tmolteno/TART/doc/README.md

# TART Radio Telescope Documentation

* [Getting Started](getting_started/README.md)
* [Calibration](calibration/README.md)

## Miscellaneous Other Documentation

This is contained in the misc subfolder.
