tmolteno/TART/hardware/antenna/README.md

# Antenna Design for TART

## Conventional GPS antenna

The TART telescope can operate with standard off-the-shelf antennas

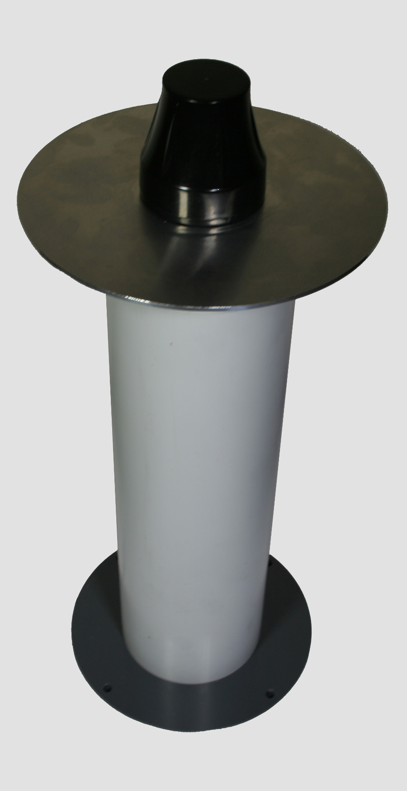
[picture p5: doc/img/antenna.jpg]
All-sky antenna on a pedestal (for snow clearance)
  

## Other Antenna Ideas

Goal. A simple radiation pattern insensitive to polarization with approximately 90 degree beam width.

[antenna_image]: https://github.com/tmolteno/TART/blob/master/doc/img/antenna.jpg "All-sky GPS antenna"
