tmolteno/TART/software/python_modules/tart_web_api/tart_web_api/README.md

# TART Web API service

This is a restful API service that runs on the raspberry pi that controls the telescope.

## Installation

This is installed using docker. See the TART/scripts directory for install instructions.
