tmolteno/TART/software/containers/web_app/web-app/api_imaging/README.md

# TART Synthesis

Provide visibilities and antenna positions as well as imaging parameters to this module. Returns a canvas of the synthesis image (`dirty image`).

## Install

```
sudo apt-get install nodejs-legacy
sudo npm install npm -g
npm install
```

## Build Example

    make exa

## Run example

    firefox ./example/index.html

NOTE: This does not work if webpack uses production mode!
