tmolteno/TART/software/python_modules/tart/tart/test/full_sim_spectrum.png

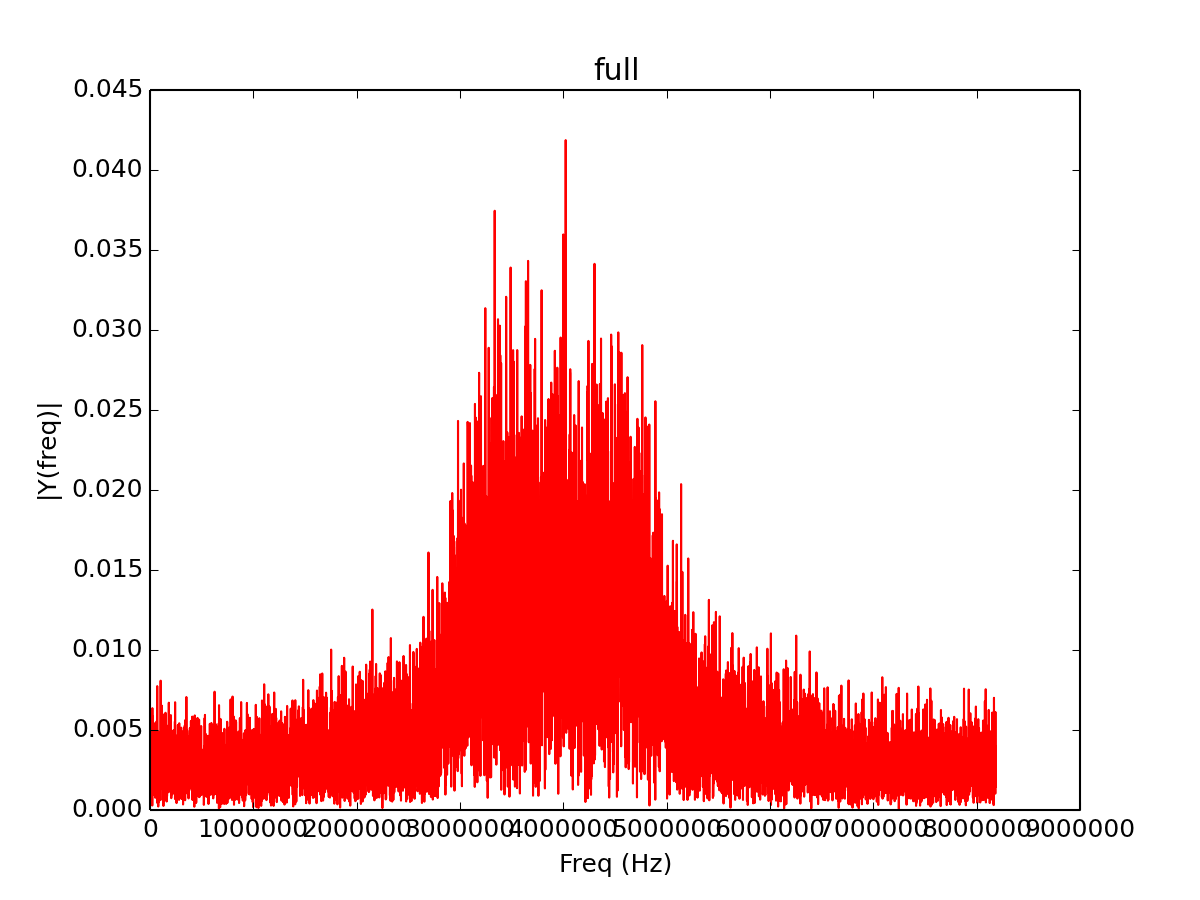
software/python_modules/tart/tart/test/full_sim_spectrum.png
