tmolteno/TART/hardware/antenna/base.fcstd

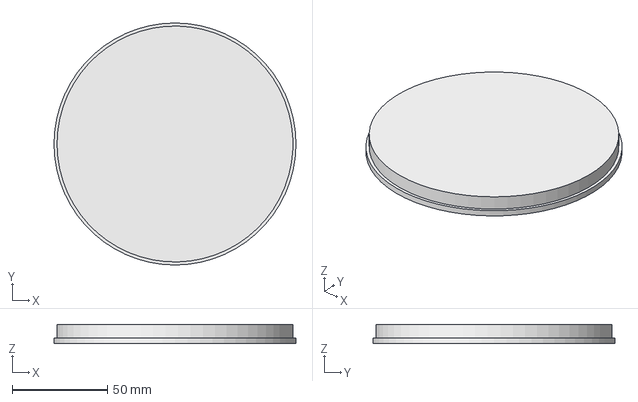
[picture p9: CAD file, 2016-05-03]
hardware/antenna/base.fcstd
127.0 x 127.0 x 10.0 mm
