tmolteno/TART/hardware/antenna/cylinder.fcstd

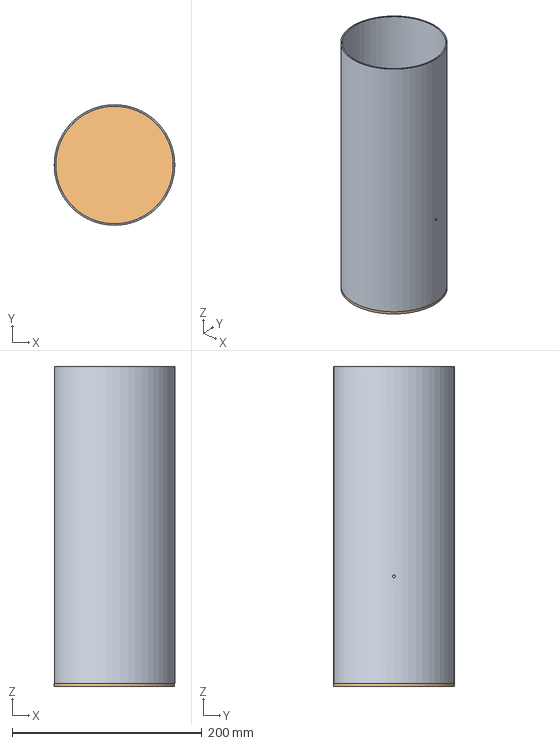
[picture p10: CAD file, 2016-05-03]
hardware/antenna/cylinder.fcstd
127.0 x 126.9 x 337.0 mm
