tmolteno/TART/hardware/FPGA/INSTALL.md

# TART FPGA INSTALL

Compiling the Verilog code that describes the FPGA functionality requires the Xilinx toolchain. 

## INSTALL CURRENT FIRMWARE

To simply install the current, the FPGA must be programmed.

## Firmware development
