tmolteno/TART/software/python_modules/tart/tart/test/test_data/signal_means.png

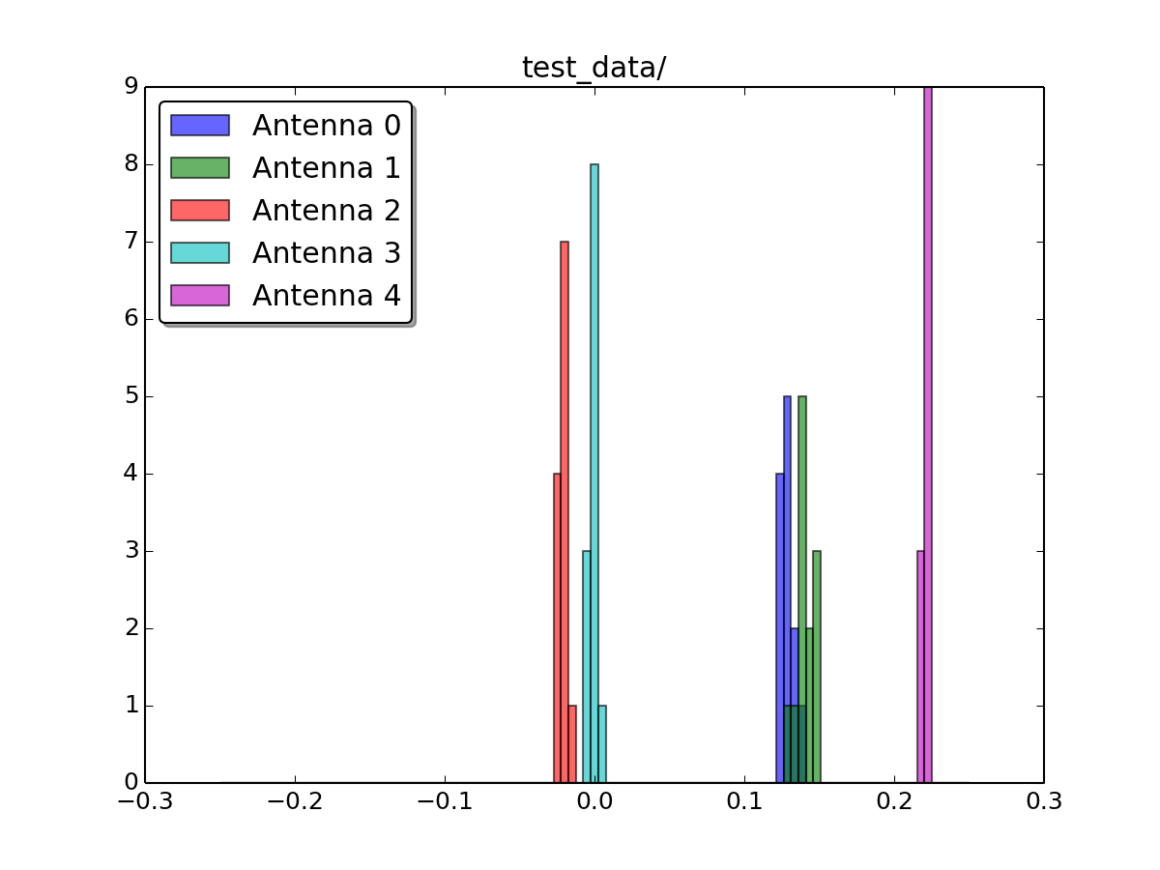
software/python_modules/tart/tart/test/test_data/signal_means.png
