tmolteno/TART/(threads)

Thread 1 (2014-08-21):

Merge Radio Board and Jitter Cleaner Module

tmolteno, 2014-08-21:
Rename ClockModule + Radio Board -> Radio Hub

Add mounting holes
Cleanup Silk Screen
1.6 mm board.

tmolteno, 2015-02-03:
Completed an uploaded to GIT.

Closed 2015-02-03.

Thread 2 (2014-11-23):

SPI speed limitation to 7.8 MHz

maxscheel, 2014-11-23:
Papillio Pro <-> RPi SPI speed limited to 7.8 MHz.
Faster speeds will cause issues as the Papillio latches to the sclk provided by the RPI. 96 MHz is too slow to latch to rising and falling edge. SPI client needs a make over.

tmolteno, 2016-05-14:
Now being worked on.  SPI rewrite in progress by @patsuggate

psuggate, 2016-05-14:
Hey Tim,

How'd ya do that?

On Sat, May 14, 2016 at 7:41 PM, Tim Molteno <notifications@github.com>
wrote:

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

Closed 2016-06-27.

Thread 5 (2017-07-05):

Web-App Enhancements

tmolteno, 2017-07-05:
Checklist of minor enhancements for the Web-GUI [https://tart.elec.ac.nz](url)

- [x] Add version number to bottom
- [x] Fix API documentation link
- [x] Add meta-information to the image view pane (date, number of baselines, integration time e.t.c)
- [x] Add telescope information to the landing page (location, number of antennas e.t.c)
- [x] Add a loading screen
- [x] Change title to "Radio Telescope Console" from TartApp

milletf1, 2017-07-05:
I have managed to get the API link to serve up api documentation.  However, it is setting the browser address to localhost/doc/.  I think this is caused by the nginx config because the response headers are returning Location: "http://localhost/doc/".

tmolteno, 2017-07-12:
Closing, as these have been largely done. Any refinement and we'll create a new issue.

Closed 2017-07-12.

Thread 6 (2017-07-06):

Spectrum View

tmolteno, 2017-07-06:
Needs to acquire raw data, will be very slow via the API.

tmolteno, 2017-07-06:
Can downscale so the FFT is faster.

maxscheel, 2017-07-26:
API now returns two additional keys 'freq' and 'power'
http://tart2-raspberry/api/v1/status/channel/0
http://tart2-raspberry/api/v1/status/channel
display power(y) vs freq(x) with perhaps:
http://www.chartjs.org/samples/latest/charts/scatter/basic.html

Closed 2017-08-02.

Thread 9 (2017-07-09):

Image time is incorrect

tmolteno, 2017-07-09:
The image time appears to be 12 hours early. At 09:14 on Monday July 10 NZST it displays.

Recorded: Sun Jul 09 2017 21:14:59 GMT+1200 (NZST).

Correct behaviour is for the API to return UTC, and the browser to display in local time.

tmolteno, 2017-07-09:
The API http://tart2-raspberry/api/v1/imaging/timestamp uses isoformat() but does not include a time zone. Here is an example: 2017-07-09T21:25:03.794269. I suspect the error is in the JavaScript that should interpret this as an UTC time.

milletf1, 2017-07-09:
I can get it to display the time like 10/07/2017, 09:27:03.  Is that what you had in mind?

tmolteno, 2017-07-09:
I think that in web-app/src/app/services/imaging.service.ts, the getTimeStamp method should convert to local time, or set the time zone on a Date object to UTC. Then the javascript can display knowing the correct time zone.

tmolteno, 2017-07-09:
Alternatively the API should include a time zone of UTC in the string?

milletf1, 2017-07-09:
date.toLocaleString() outputs the time as I have displayed above.

tmolteno, 2017-07-09:
Perhaps the issue is browser dependent. I'm on a Chromebook, and the image from Monday morning shows a time 12 hours early (it does include NZDT, it just happens to be 12 hours out)

Closed 2017-07-12.

Thread 10 (2017-07-12):

Default imaging interval should be 15

tmolteno, 2017-07-12:
One some slow browsers (i.e. firefox on android) with slow connections the 5 second refresh interval seems too fast  - it takes longer than 5s to render. Suggest 15?

milletf1, 2017-07-12:
Sounds good, I will add this to my next commit.

Closed 2017-07-12.

Thread 18 (2017-07-19):

Error in status map

tmolteno, 2017-07-19:
On firefox, I get "TypeError: i.ellipse is not a function". When using the status map.

Stacktrace.
.sTWA/s</e.prototype.drawAntennaPositions/<()
forEach()
.sTWA/s</e.prototype.drawAntennaPositions()
.sTWA/s</e.prototype.ngOnChanges()
.SMJ5/x</e.prototype.ngDoCheck()
.B3Ku/V</t.prototype.detectChangesInternal()

tmolteno, 2017-07-19:
Confirmed as fixed.

Closed 2017-07-19.

Thread 19 (2017-07-20):

colourscale array gets truncated by webpack

maxscheel, 2017-07-20:
some colourmaps are not available

maxscheel, 2017-07-20:
not important issue. something todo with webpack exports

milletf1, 2017-07-24:
I think the problem is that the colours that you want aren't available in version 1.x.x, which is the version of colormap that is required by apply-colormap.

Closed 2017-07-26.

Thread 22 (2017-07-24):

colour selection for vis imaging only works on localhost

milletf1, 2017-07-24:
Not sure why this is, will try fix tomorrow.

milletf1, 2017-07-24:
This issue is being caused when the save-pixels package is given an array of  coloured pixels in production builds.  I'll debug this at a later date.

maxscheel, 2017-07-26:
lets just use our own colouring. i updated the api_synthesis package to only depend on colormap (with viridis support) and removed dep to apply_colormap (not maintained.)

providing "viridis" now working.

Closed 2017-07-26.

Thread 23 (2017-07-26):

API - Number of samples exponent in vis mode

maxscheel, 2017-07-26:
Number of samples exponent when changed, need to reconfigure the FPGA. Changing values breaks telescope process (API will still run, but telescope won't react)

psuggate, 2017-07-26:
The hardware won't automatically issue a reset & flush the buffers, if the exponent is changed mid-calculation, so you'll have to do that from the RPi, and change the web-app's state accordingly?

maxscheel, 2017-07-26:
Yip. Don't worry, I'll handle it. No action required from your side :)

Thread 28 (2017-08-24):

WebM Encoder using ffmpeg.js

tmolteno, 2017-08-24:
The npm package ffmpeg.js a pretty powerful video encoder that runs in the browser. It can encode a sequence of images to a webM movie. The specific package is probable (ffmpeg-worker-webm.js).

See: https://stackoverflow.com/questions/40560255/ffmpeg-jpeg-stream-to-webm-only-creates-a-file-webm-with-1-frame-snapshot-or

Also: https://github.com/spite/ccapture.js/

Thread 29 (2017-08-29):

Upgraded clock distribution on radio hub boards

tmolteno, 2017-08-29:
Use a zero-delay clock buffer in place of the jitter cleaner, driving a RC low pass filter.

* Tune filter to achieve the right output level, and reasonable cut-off.
* Shift board to Kikad
* Reuse existing radio modules.
* Use new driver chips.

Thread 33 (2018-03-16):

Extracting individual antenna signals

danieludick, 2018-03-16:
Good day,

I would like to extract the individual (time sampled) signals from each of the antennas for our setup in SA. I am logging in to my Raspberry pi and I execute:

``
/git/TART/software/python/tart/tart/simulation $ python telescope_system.py
``

I am however getting the following error:

``
Traceback (most recent call last):
  File "telescope_system.py", line 13, in <module>
    rad = radio.Max2769B(sample_duration = 1e-5)
TypeError: __init__() got an unexpected keyword argument 'sample_duration'
``

The installation is also already up to date (I think). After pulling from the repo, I issued:

``
/home/pi/git/TART/software/python/tart_web_api and issue: sudo python setup.py install
``

Perhaps there is another setup.py to run?

danieludick, 2018-03-16:
There is another script that I located (test_radio.py), that looks useful here. When I run it however, then it also exhibits an issue:

``
pi@tart2-orange:~/git/TART/software/python/tart/tart/simulation/test $ python test_radio.py
Traceback (most recent call last):
  File "test_radio.py", line 10, in <module>
    from tart.simulation import spectrum
ImportError: cannot import name spectrum
``

maxscheel, 2018-03-16:
Hi Danie,
You went down the wrong rabbit hole and discovered lots of software/bit rot :1st_place_medal:

Ideally you want to download the raw data file to your desktop. On your desktop should already have the tart python package installed (pip install tart)

I just added a simple script for time sampled signals from raw data pkl files in:
TART/doc/getting_started/time_sampled_signals.py

The latter is a stripped version of the spectrum generation from raw data which can be found here:
TART/doc/getting_further/spectrum/raw_data_info.py

Thread 35 (2018-04-14):

external paths still exist in web api

maxscheel, 2018-04-14:
currently requires (hardcoded) folder called 24_ant_setup with:
a) telescope_config.json
b) calibrated_antenna_positions.json
this is also the path where the gains.db sqlite data base is stored.

changes need to made in:
tart_web_api/config.py
tart_web_api/database.py

make sure that api can be installed and run by just 2 steps.
1) sudo pip install tart_web_api
2) LOGIN_PW=foobar FLASK_APP=tart_web_api flask run

tmolteno, 2019-02-14:
This has been fixed (to some extent) in the recent containerised web_api. Persistence is still being worked on.

tmolteno, 2019-07-11:
Closed as the API is now containerised

Closed 2019-07-11.

Thread 36 (2019-02-06):

Errors while building the Docker containers (calibration_server, object_position_server)

danieludick, 2019-02-06:
I am currently trying to setup a calibration server for our TART telescope in SA. First off, I want to get the object_position_server going and tested on an Ubuntu machine. I am getting the following error after following the README.md file contained in that directory:

> $ docker-compose build
> Docker machine "default" does not exist. Use "docker-machine ls" to list machines. Use "docker-machine create" to add a new one.
>

For reference, I am unexperienced with Docker and might not have installed everything that is required. I did the following:

> sudo snap install docker
> sudo apt install docker-compose

Is there anything I am missing?

danieludick, 2019-02-06:
I seemed to have moved a bit further now by issuing:

> sudo docker-compose build

But still I get that the build failed due to:

> ERROR: Service 'object-position-server' failed to build: The command '/bin/sh -c apt-get install -y python-numpy python-dateutil' returned a non-zero code: 100

The full output are as follows:

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

```

tmolteno, 2019-02-06:
The issues appear to be related to external web access on the machine. The docker image is unable to access the external repositories (deb.debian.org) to get the list of software. This means it can't find the numpy and dateutil packages.

More specifically, It seems that the DNS system on the computer running docker does not resolve the 'deb.debian.org' domain name. Could you check the output of the following command (assuming you're running some form of Linux)

    wget http://deb.debian.org/debian/dists/stretch/

Your output should look something like...

```
$ wget http://deb.debian.org/debian/dists/stretch/
--2019-02-07 09:08:33--  http://deb.debian.org/debian/dists/stretch/
Resolving deb.debian.org (deb.debian.org)... 149.20.4.15, 128.31.0.62, 130.89.148.14, ...
Connecting to deb.debian.org (deb.debian.org)|149.20.4.15|:80... connected.
HTTP request sent, awaiting response... 302 Found
Location: http://cdn-fastly.deb.debian.org/debian/dists/stretch/ [following]
--2019-02-07 09:08:34--  http://cdn-fastly.deb.debian.org/debian/dists/stretch/
Resolving cdn-fastly.deb.debian.org (cdn-fastly.deb.debian.org)... 151.101.232.204, 2a04:4e42:37::204
Connecting to cdn-fastly.deb.debian.org (cdn-fastly.deb.debian.org)|151.101.232.204|:80... connected.
HTTP request sent, awaiting response... 200 OK
Length: 1801 (1.8K) [text/html]
Saving to: ‘index.html’
```

danieludick, 2019-02-07:
Thanks @tmolteno . I ran now the command you suggested and got the following (seems to be what is expected):

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

I then tried the following again:

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

danieludick, 2019-02-07:
This seems to be a networking/firewall issue with our University. I tried now with another Ubuntu PC connected to the internet and was able to get the following output after issuing:
> docker-compose build

Output:

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

Then following the steps in the [README.md](https://github.com/tmolteno/TART/tree/master/software/containers/object_position_server/README.md) I did the following:

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

Not sure if this error is really an issue? I tested it as follows:

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

So it seems to be working. Not sure the networking issue is worth trying to resolve. I am going to continue with the calibration server install now on this PC outside of the network that gives issues, and then try and connect it to the Univ. network afterwards to calibrate the TART system we have here.

danieludick, 2019-02-07:
Started now with the calibration_server (also on the same host where the object detection server is running). Running in to the following error when running **sh build.sh**:

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

tmolteno, 2019-02-07:
Thanks for the report. It looks like the docker image was based on a testing distribution of debian where those packages had been temporarily disabled. I'm curently testing a fix to base it off a stable version.

tmolteno, 2019-02-07:
@danieludick  Could you please pull the latest version, it seems to fix the issue here at least.

danieludick, 2019-02-08:
Thanks @tmolteno . Pulling the latest version seemd to work :). The calibration is still running. I will close the issue once I can confirm that everything works as expected.

tmolteno, 2019-02-13:
@danieludick  I have made a few documentation changes to try and avoid duplicating instructions for software installation, and also to make the flow a little more logical.

danieludick, 2019-02-21:
Just a note on this issue:

- To get the Docker installation sorted out on Ubuntu 18.02, one should follow steps as outlined on https://www.digitalocean.com/community/tutorials/how-to-install-and-use-docker-on-ubuntu-18-04, as the Docker installation package available in the official Ubuntu repository may not be the latest version.

- Also for the Object position server, I had to change the following in the Dockerfile:

> #FROM debian:stretch-slim
> FROM debian:stretch

Then everything built. The servers are now installed on my machine and I am going to close this issue.

Closed 2019-02-21.

Thread 37 (2019-02-14):

Antenna positions not uploaded correcty to (SA) TART

danieludick, 2019-02-14:
As part of the S.A. TART calibration process, I measured the antenna positions. This was done according to the Jupyter notebook listed in https://github.com/tmolteno/TART/tree/master/doc/calibration/positions.

I  replaced all the measurements wiith our ones. Something that I did however change, was the antenna positions, which is entered into the following array (which accordingly is the distance from each antenna to the reference poles: x0, x1 and x2).

> m[0,:] = [1563, 855, 2618]

I assumed the above example was incorrect, as the order of the columns 1 and 2 is interchanged, i.e. it should be:

> m[0,:] = [855,1563, 2618]

After entering our data, I generated the attached JSON file: (note i merely renamed it to .txt for the upload to Github): [tart_positions_2019-02-14.txt](https://github.com/tmolteno/TART/files/2865369/tart_positions_2019-02-14.txt)

I then submitted the data to the TART, as follows:

> /usr/local/bin/tart_upload_antenna_positions --api http://146.232.222.105 --pw changethispw --file tart_positions_2019-02-14.json

 and received the response:

> Response: {}

I then downloaded the antenna gains again from our TART (in order to verify that they are properly set), but they did not correspond to what I uploaded (see the attached file): [antenna_positions.txt](https://github.com/tmolteno/TART/files/2865378/antenna_positions.txt)

However, after putting our TART in Diagnose mode, the status map of the antennas changed completely:

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

This is not correct.

I am probably doing something wrong here. Should I also add the antenna positions as in the example, i.e. [distance from antenna to x1, ..x0, x2 ] ?

tmolteno, 2019-02-14:
Thanks for the report. Looking into it at the moment, and suspect that the API-uploaded telescope positions aren't sticking properly. Will update when I find more.

The positions can also be updated by modifying the json file in
     software/telescope_web_api/config_data/calibrated_antenna_positions.json
and rebuilding the docker module (docker-compose build in the top level directory)
These positions are then permanently modified (the API uploaded ones don't survive a reboot)

tmolteno, 2019-02-14:
The notebook is very ambiguous, so I have updated it. The m[i,j] are the measurements (in mm) from x1, x0, x2 respectively - yes its very confusing!

tmolteno, 2019-02-15:
I have updated the tart-tools package. Please update with

    sudo pip install tart-tools --upgrade

This will report more useful error messages, as well as reporting 'SUCCESS' if the upload works. Also have updated the documentation to use the tart-tools binaries for uploading.

tmolteno, 2019-07-11:
Closing this as I believe this issue has been worked out.

Closed 2019-07-11.

Thread 38 (2019-02-15):

REPORT better errors when the binary tools fail

tmolteno, 2019-02-15:
The current tools report a not-very-useful "Response: {}" when they correctly upload gains or positions. Change this to SUCCESS.

Closed 2019-02-15.

Thread 39 (2019-02-21):

TART-ZA (TART in South Africa) remains uncalibrated even after running continuous calibration script

danieludick, 2019-02-21:
After installing the latest object detection server and calibration software on my Ubuntu 18.04 PC, I am not having any luck with our TART system in SA.

For reference, the image produced looks as follows:

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

Just for reference, this calibration was run using the following:

> sudo docker run --rm -d -e TART_LOGIN_PW=SAPWD -e TART_API=http://146.232.222.105 -v ~/calibration_results:/app --name=cal -it tart_calibration_server

Then I did:

> docker exec -it cal bash

And when inside the bash attached to this docker machine, I executed the following:

> sh /tart_calibrate.sh

The following output snippet was produced:

```
...
Calibration output is in /app/cal_2019_02_20_15_38_37.json
SUCCESS
Uploading new antenna positions
SUCCESS

```

There is a directory in my $HOME with the following content:

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

I have attached now the file cal_2019_02_20_15_38_37.json (added .txt extension to get it on GitHub):

[cal_2019_02_20_15_38_37.json.txt](https://github.com/tmolteno/TART/files/2887790/cal_2019_02_20_15_38_37.json.txt)

danieludick, 2019-02-21:
Just also to mention: The software on our Raspberry Pi for TART-ZA is still running the original code that was sent to us. After performing antenna position measurements (as documented here), I uploaded the following files to the Pi's directory: **/home/pi/git/TART/hardware/rpi/24_ant_setup**

[calibrated_antenna_positions.json.txt](https://github.com/tmolteno/TART/files/2887811/calibrated_antenna_positions.json.txt)
[telescope_config.json.txt](https://github.com/tmolteno/TART/files/2887812/telescope_config.json.txt)

tmolteno, 2019-02-21:
Thanks for the report. The calibration minimum is returning -7 (this is a log of the function that is minimising) and usually we get around -11.0. A couple of questions.

1) Could you check the timing of the files. There appear to be two files created with close together dates (roughly 2.5 minutes apart) . Is there a chance that you're running two copies of the calibration script? (this shouldn't really stop the calibration working however).

2) Are the diagnose mode outputs showing all green in the telescope web application?

danieludick, 2019-02-21:
The status map of the antennas show all green:

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

I did observe just after uploading this, that one of the status flags changed red for a short duration. but is back on green now.

Also seems there is some strong source nearby:

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

Also clear when looking at the spectra (here the antenna that shows a

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

tmolteno, 2019-02-21:
There looks to be a fair amount of RF interference in those spectra. Here is a single antenna spectrum from a telescope at a quiet site:

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

danieludick, 2019-02-22:
Thanks @tmolteno . Added now the calibration.log file

[calibrate.log](https://github.com/tmolteno/TART/files/2893055/calibrate.log)

tmolteno, 2019-02-23:
Thanks for the log file, the calibration process is not doing a good job of finding good phases and gains. I will try and come up with a good way to check for RF interference.

The visibilities can be retrieved from the telescope via the API. Here is how to get them from our live telescope: (https://tart.elec.ac.nz/signal/api/v1/imaging/vis). This will list the real and imaginary parts of the visibilities.

If there is strong RFI, the visibility amplitudes may be approaching 1.0. Typically they should be around 0.2. What numbers are you getting?

**I've just noticed that there is a very bright satellite (LUCH 5A) dominating the sky here. This may cause calibration issues.**

tmolteno, 2019-02-23:
You can monitor visibilities using the script in /github/TART/doc/calibration/radio_hub. The following command will show the antenna pair 2-3 visibility as a function of time.

    python monitor_vis.py --api https://tart.elec.ac.nz/signal --i 2 --j 3

danieludick, 2019-02-24:
Thanks @tmolteno . I will check the visibilities. Looking at the spectra, I also see that one of the Radio Hubs might be exhibiting on-board RFI (see Antenna 12 cluster).

We are planning to build also a new Radio Hub board. If you get a chance, will you please upload a bill of materials for the components.

danieludick, 2019-03-01:
Plotted now the monitored visibilities using the monitor_vis.py script for antennas 2 and 3:

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

tmolteno, 2019-03-04:
Hi @danieludick. The BOM has been uploaded to

     hardware/pcb/radio_hub_module/RadioHub2.1/RadioHub2.1_.html

Apologies for the delay.

tmolteno, 2019-03-04:
Those visibilities look reasonable, in that the phase is slowly changing (Consistent with things moving over the sky). Could you run the command for a short baseline pair, and a long baseline pair (roughly east-west) and you should see the phase changing faster in the long pair, vs the short pair.

Thread 41 (2019-06-14):

TARTZA installation fails with docker-compose up

danieludick, 2019-06-14:
We are currently in a process of updating our TART in SA (i.e. TARTZA) to Python3. After installing Raspbian v9 (stretch) on a Pi 3B+, we still cannot get the new telescope software to run.

We completed all steps detailed in the [README](https://github.com/tmolteno/TART/blob/master/software/README.md) but when we execute `docker-compose up` we get a range of errors, including the following:

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

Do you have any recommendations for us?

danieludick, 2019-06-14:
Please note, we have not made any changes to the FPGA software (that is still running the original code that we received with our TART).

tmolteno, 2019-06-17:
I will look into this, and try and duplicate it here. Can you issue the following command on the pi (in the software directory)

    docker-compose logs > logs.txt

And then attach the file logs.txt (providing it isn't more than 1MB). Also the output of the following command:

    uname -a
    df -k

Which should get the exact version of the system and the amount of free space available.

danieludick, 2019-06-17:
Thanks @tmolteno . Attached is the [logs.txt](https://github.com/tmolteno/TART/files/3296170/logs.txt) file and here is the output from the other commands:

```
pi@tartZA:~/TART-master/software $ uname -a
Linux tartZA 4.14.98-v7+ #1200 SMP Tue Feb 12 20:27:48 GMT 2019 armv7l GNU/Linux

pi@tartZA:~/TART-master/software $ df -kh
Filesystem      Size  Used Avail Use% Mounted on
/dev/root        15G  7.2G  6.7G  52% /
devtmpfs        460M     0  460M   0% /dev
tmpfs           464M     0  464M   0% /dev/shm
tmpfs           464M   30M  434M   7% /run
tmpfs           5.0M  4.0K  5.0M   1% /run/lock
tmpfs           464M     0  464M   0% /sys/fs/cgroup
/dev/mmcblk0p1   43M   22M   21M  51% /boot
tmpfs            93M     0   93M   0% /run/user/1000
```

tmolteno, 2019-06-18:
I think it is due to a mismatch in package versions. I am res-installing from scratch on a new machine. Should know by tomorrow morning (NZ time)

tmolteno, 2019-06-18:
I have reinstalled and it appears to be working. One issue might be the need to enable SPI on the raspberry Pi. I have made a few few updates to the README in TART/software (as docker-compose requires a few prerequisites to install).  I used a new RPi install disk and did...

1. Download new Stretch Lite installation from https://www.raspberrypi.org/downloads/raspbian/
2. Install onto new SD card (/dev/sdc on my system)
    unzip 2019-04-08-raspbian-stretch-lite.zip
    sudo dd if=2019-04-08-raspbian-stretch-lite.img of=/dev/sdc bs=4M
    sync
2. Insert uSD card into Pi and boot.
3. Log in an sudo raspbi-config
    - enable SSH server
    - enable SPI interface
    - take note of IP address
    sudo apt update
    sudo apt upgrade

4. Follow steps in software/README.md after logging in via SSH
    ssh pi@testpi.local

5. The Web interface appears and visibility mode can be enabled and data retrieved by SPI.

Could you check whether SPI was enabled on the Pi?

Tim

tmolteno, 2019-07-11:
Think this may have been due to line endings caused by transferring files from a windows host to the RPi SD card. Closing this issue for now. Please reopen if there are further problems.

19173296, 2021-04-13:
Hello. I am experiencing the exact same issue trying to update TART-ZA to the latest build. I followed this post in conjunction with the software README guide. I used a linux pc to create the Pi's sd card and copied the TART repo to the Pi. SPI and SSH is enabled and I can build and run the docker files, but It seems that the software_api_container keeps restarting every couple of seconds. The website is up, but I cannot log in with the default password. The latitude and  longitude stats also doesn't load. screenshot of the web interface:
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

'docker container ls -a' prints:
CONTAINER ID        IMAGE                     COMMAND                  CREATED             STATUS                          PORTS                  NAMES
b599dc30f638        software_web_app          "nginx -g 'daemon of…"   41 minutes ago      Up 38 minutes                   0.0.0.0:80->80/tcp     software_web_app_1
0befcfcb6bf1        software_api_doc_server   "nginx -g 'daemon of…"   41 minutes ago      Up 38 minutes                   0.0.0.0:8080->80/tcp   software_api_doc_server_1
4734f5353b27        software_api_container    "/bin/sh -c 'flask r…"   41 minutes ago      Restarting (1) 52 seconds ago                          software_api_container_1

'uname -a' prints:
Linux tartza 5.10.17-v7+ #1403 SMP Mon Feb 22 11:29:51 GMT 2021 armv7l GNU/Linux
and df -k prints:
Filesystem     1K-blocks    Used Available Use% Mounted on
/dev/root       15020844 3990816  10387076  28% /
devtmpfs          439916       0    439916   0% /dev
tmpfs             473196       0    473196   0% /dev/shm
tmpfs             473196   18268    454928   4% /run
tmpfs               5120       4      5116   1% /run/lock
tmpfs             473196       0    473196   0% /sys/fs/cgroup
/dev/mmcblk0p1    258095   48782    209314  19% /boot
tmpfs              94636       0     94636   0% /run/user/1000

This is the docker logs:
[logs.txt](https://github.com/tmolteno/TART/files/6306119/logs.txt)

I can provide an direct ssh link to the pi if you want to have a look at the install on our pi
Thank you for your time

tmolteno, 2021-04-13:
OK. Looks like the permute.txt file in the tart_hardware_interface module is not being loaded.

```
api_container_1   |   File "/usr/local/lib/python3.7/dist-packages/tart_hardware_interface-0.2.0b3-py3.7.egg/tart_hardware_interface/tartspi.py", line 8, in <module>
api_container_1   |   File "/usr/lib/python3/dist-packages/pkg_resources/__init__.py", line 1145, in resource_filename
api_container_1   |     self, resource_name
api_container_1   |   File "/usr/lib/python3/dist-packages/pkg_resources/__init__.py", line 1715, in get_resource_filename
api_container_1   |     return self._extract_resource(manager, zip_path)
api_container_1   |   File "/usr/lib/python3/dist-packages/pkg_resources/__init__.py", line 1736, in _extract_resource
api_container_1   |     timestamp, size = self._get_date_and_size(self.zipinfo[zip_path])
api_container_1   | KeyError: 'tart_hardware_interface/permute.txt'
```

This might be due to a change in how this is done. I'll look into it today.

tmolteno, 2021-04-13:
Can you check on the raspberry pi for the existence of a file.

    docker-compose -f docker-compose-client.yml exec api_container /bin/bash
    find / -name 'permute.txt'

On our TART we get the following.
`root@0f3a0242593f:/app# find / -name 'permute.txt'
find: '/proc/19350/task/19350/net': Invalid argument
find: '/proc/19350/net': Invalid argument
/root/.cache/Python-Eggs/tart_hardware_interface-0.2.0b3-py3.7.egg-tmp/tart_hardware_interface/permute.txt
/python_code/tart_hardware_interface/tart_hardware_interface/permute.txt
/python_code/tart_hardware_interface/build/lib/tart_hardware_interface/permute.txt
`

19173296, 2021-04-14:
The container restarts before find can complete a search for the 'permute.txt' file.
Results:
```
pi@tartza:~/software $ sudo docker-compose -f docker-compose.yml exec api_container /bin/bash
root@22a83b2fb234:/app# find / -name 'permute.txt'
root@22a83b2fb234:/app# pi@tartza:~/software $
```

19173296, 2021-04-14:
I solved the issue. The permute.txt was not in the tart_hardware_interface folder.
Copying the permute.txt from TART/hardware/FPGA/tart_spi/data to TART/software/python_modules/tart_hardware_interface/tart_hardware_interface/  before running docker-compose build did the trick.
Thank you for the help

tmolteno, 2021-04-14:
Excellent news. Glad I could help.

Thread 43 (2019-07-25):

Store Calibration Data in the Raw Data File

tmolteno, 2019-07-25:
The current state of the calibration data should be stored in the raw data file when it is gathered. Otherwise the raw data files can't easily be imaged from without downloading this data via the API at the time that the data file was generated.

- [x] Add the Antenna Positions (to the config)
- [x] Add the current Calibration Data to the config
- [x] Make sure the full config is in the RAW file
- [x] Make sure the full config is in the VIS file
- [x] Put a version into the HDF file, and check for this when loading files (to avoid trying to load calibration data if it isn't there. (Required for backward compatibility)

Closed 2020-09-14.

Thread 48 (2020-03-29):

Unable to load historic *.pkl files

danieludick, 2020-03-29:
I am trying to convert the attached *.pkl file that was generated with the Stellenbosch University TART, but I am unable to do so using the latest `tart` package (version 0.15.5).

I am running the following Python code and passing it the attached *.pkl file:

```
# ==================================================================================================
# Danie Ludick (2020)
# dludick@sun.ac.za
#
# Description:
#    Converts TART raw data (in *.pkl format to MATLAB *.mat data object)
#    Note, this assumes that you have installed the tart package: "sudo pip3 install tart"

import scipy.io
import pickle
from tart.operation import observation
import argparse

# =================================================================================================
# Main driver
# =================================================================================================
if __name__ == '__main__':

  PARSER = argparse.ArgumentParser(description='Convert raw data from the TART telescope to MATLAB compatible format')
  PARSER.add_argument('--file', required=True, help="The raw data *.pkl file ")

  ARGS = PARSER.parse_args()

  print("Convert tart raw data v1.0 from 2020-03-29")
  print("")

  # Load the Observation file (i.e. the PKL file)
  obs = observation.Observation_Load(ARGS.file)

  # Extract information from the *.pkl file
  print("  Sampling time-stamp   : %s " % str(obs.timestamp))
  print("  Number of Samples     : %d " % len(obs.data[ANTENNA_INDEX]))
  print("  Number of Antenna     : %d " % obs.config.get_num_antenna())
  fs =  obs.get_sampling_rate()
  print("  Sampling rate [Hz]    : %d " % fs)

  scipy.io.savemat('tart_matlab_data', mdict={'version':1, \
                                              'timestamp': str(obs.timestamp), \
                                              'sampling_rate': fs, \
                                              'number_of_antennas': obs.config.get_num_antenna(), \
                                              'antenna_channels_raw_data':obs.data})
```
I get the following error:

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

danieludick, 2020-03-29:
I think this issue is merely a result of the data being stored in *.pkl format using Python2 and then I try to extract is using Python3.

When extracting the *.pkl data directly using Python2.7 with the following script, then it seems to work:

>     load_data = gzip.open(filename, 'rb')
>     d = pickle.load(load_data)
>     print(d)

tmolteno, 2020-05-13:
I think the longer term solution is to create a conversion utility that moves the old .pkl files to .hdf. This would have to be written in python2.7 so might only work while python2 can be used (it has been deprecated).

Thread 67 (2021-06-03):

Antenna Beam Modeling

tmolteno, 2021-06-03:
This is an important part of enhanced calibration as well as new inference algorithms. This issue is a placeholder. Andre Offringa suggests EveryBeam as a package that can model beam patterns. Meerkat uses FITS images - however Andre says this is inefficient as one needs a different image for each antenna and each frequency and for each elevation. By expanding the beam in basis functions, one can interpolate in frequency space to calculate beams at different frequencies.

- [ ] Choose a technique (FITS or Basis functions). Tim prefers the latter.
- [ ] Be able to generate a fits image from the basis functions, so that other packages can be used for imaging.
- [ ] Allow modeling to determine beam packages (e.g. from Numerical EM packages) so reading output from FEKO might be useful.
