tmolteno/TART/hardware/FPGA/zynq/constraints.xdc

set_property PACKAGE_PIN K17 [get_ports rx_clk_16]
set_property PACKAGE_PIN B19 [get_ports {antenna[0]}]
set_property PACKAGE_PIN J15 [get_ports {antenna[1]}]
set_property PACKAGE_PIN A20 [get_ports {antenna[2]}]
set_property PACKAGE_PIN D20 [get_ports {antenna[3]}]
set_property PACKAGE_PIN F16 [get_ports {antenna[4]}]
set_property PACKAGE_PIN D19 [get_ports {antenna[5]}]
set_property IOSTANDARD LVTTL [get_ports rx_clk_16]
set_property IOSTANDARD LVTTL [get_ports {antenna[0]}]
set_property IOSTANDARD LVTTL [get_ports {antenna[1]}]
set_property IOSTANDARD LVTTL [get_ports {antenna[2]}]
set_property IOSTANDARD LVTTL [get_ports {antenna[3]}]
set_property IOSTANDARD LVTTL [get_ports {antenna[4]}]
set_property IOSTANDARD LVTTL [get_ports {antenna[5]}]

set_property IOSTANDARD LVTTL [get_ports clk_locked]
set_property IOSTANDARD LVTTL [get_ports clk_o]
set_property PACKAGE_PIN M18 [get_ports clk_o]
set_property PACKAGE_PIN M17 [get_ports clk_locked]


set_property IOSTANDARD LVTTL [get_ports {antenna[23]}]
set_property IOSTANDARD LVTTL [get_ports {antenna[22]}]
set_property IOSTANDARD LVTTL [get_ports {antenna[7]}]
set_property IOSTANDARD LVTTL [get_ports {antenna[6]}]
set_property IOSTANDARD LVTTL [get_ports {antenna[8]}]
set_property IOSTANDARD LVTTL [get_ports {antenna[9]}]
set_property IOSTANDARD LVTTL [get_ports {antenna[10]}]
set_property IOSTANDARD LVTTL [get_ports {antenna[12]}]
set_property IOSTANDARD LVTTL [get_ports {antenna[11]}]
set_property IOSTANDARD LVTTL [get_ports {antenna[13]}]
set_property IOSTANDARD LVTTL [get_ports {antenna[14]}]
set_property IOSTANDARD LVTTL [get_ports {antenna[15]}]
set_property IOSTANDARD LVTTL [get_ports {antenna[16]}]
set_property IOSTANDARD LVTTL [get_ports {antenna[17]}]
set_property IOSTANDARD LVTTL [get_ports {antenna[18]}]
set_property IOSTANDARD LVTTL [get_ports {antenna[19]}]
set_property IOSTANDARD LVTTL [get_ports {antenna[20]}]
set_property IOSTANDARD LVTTL [get_ports {antenna[21]}]
set_property PACKAGE_PIN F17 [get_ports {antenna[6]}]
set_property PACKAGE_PIN M19 [get_ports {antenna[7]}]
set_property PACKAGE_PIN M20 [get_ports {antenna[8]}]
set_property PACKAGE_PIN K19 [get_ports {antenna[9]}]
set_property PACKAGE_PIN J19 [get_ports {antenna[10]}]
set_property PACKAGE_PIN C20 [get_ports {antenna[11]}]
set_property PACKAGE_PIN B20 [get_ports {antenna[12]}]
set_property PACKAGE_PIN E17 [get_ports {antenna[13]}]
set_property PACKAGE_PIN D18 [get_ports {antenna[14]}]
set_property PACKAGE_PIN E18 [get_ports {antenna[15]}]
set_property PACKAGE_PIN E19 [get_ports {antenna[16]}]
set_property PACKAGE_PIN L19 [get_ports {antenna[17]}]
set_property PACKAGE_PIN L20 [get_ports {antenna[18]}]
set_property PACKAGE_PIN T11 [get_ports {antenna[19]}]
set_property PACKAGE_PIN T12 [get_ports {antenna[20]}]
set_property PACKAGE_PIN T10 [get_ports {antenna[21]}]
set_property PACKAGE_PIN U12 [get_ports {antenna[22]}]
set_property PACKAGE_PIN U13 [get_ports {antenna[23]}]
