tmolteno/TART/hardware/rpi/acquire_vis_queue.py

import argparse
import numpy as np
import datetime
import time
import sys
import os, stat

import multiprocessing
import logging
import traceback

from tartdsp import TartSPI

from tart.operation import settings
from tart.imaging import visibility
from tart.imaging import calibration
from tart.util import angle

def get_corr(xor_sum, n_samples):
    return 1. - 2*xor_sum/float(n_samples)

def get_vis_object(data, n_samples, config):
    num_ant = config.num_antennas
    timestamp = datetime.datetime.utcnow()
    vis = visibility.Visibility_From_Conf(config, timestamp, angle.from_dms(90.), angle.from_dms(0.))
    v = []
    baselines = []
    xor_cos = data[0:-24:2]
    xor_sin = data[1:-24:2]
    corr_cos = get_corr(xor_cos, n_samples)
    corr_sin = get_corr(xor_sin, n_samples)
    means = (data[-24:])/float(n_samples)*2.-1
    #print means
    for i in range(0, num_ant):
      for j in range(i+1, num_ant):
          idx = len(baselines)
          baselines.append([i,j])
          #v_real = correlator.van_vleck_correction( -means[i]*means[j] + corr_cos[idx] )
          #v_imag = correlator.van_vleck_correction( -means[i]*means[j] + corr_sin[idx] )
          v_real = -means[i]*means[j] + corr_cos[idx]
          v_imag = -means[i]*means[j] + corr_sin[idx]
          v_com = v_real-1.j*v_imag
          v.append(v_com)
    vis.set_visibilities(v, baselines)
    return vis, means

def get_data(tart):
    viz = tart.vis_read(False)
    return viz[tart.perm]

'''
    Grab data and push to queue
'''
def capture_loop(process_queue, ):
    tart_instance = TartSPI()
    tart_instance.reset()
    tart_instance.read_status(True)
    permutation = tart_instance.load_permute()
    tart_instance.debug(on=False, shift=False, count=False, noisy=True)
    tart_instance.read_status(True)
    tart_instance.capture(on=True, noisy=False)
    tart_instance.start(blocksize, True)

    while True:
        try:
            # Add the data to the process queue
            data = get_data(tart_instance)
            process_queue.put(data)
        except Exception, e:
            logger.error( "Capture Loop Error %s" % str(e))
            logger.error(traceback.format_exc())

        finally:
            print  'Acquired', data[0]
            #tart_instance.close()

''' This is a separate procees that just
    waits for data to appear on the queue, and processes
    the files.
'''
def process_loop(process_queue, result_queue, config, n_samples):
    p_bool = 0
    while (True):
        if (False == process_queue.empty()):
            try:
                p_bool += 1
                if p_bool >20:
                    p_bool = 0
                    print 'ProcessQ: %i ResultQ: %i' % (process_queue.qsize(), result_queue.qsize())
                data = process_queue.get()
                vis, means = get_vis_object(data, n_samples, config)
                result_queue.put((vis, means))
            except Exception, e:
                logger.error( "Processing Error %s" % str(e))
                logger.error(traceback.format_exc())
        else:
            time.sleep(0.0001)

def result_loop(result_queue, chunk_size):
    vislist = []
    while(True):
        if (False == result_queue.empty()):
            try:
                vis, means = result_queue.get()
                vislist.append(vis)
                if len(vislist)>chunk_size:
                    fname = ARGS.vis_prefix + "_" + vis.timestamp.strftime('%Y-%m-%d_%H_%M_%S.%f')+".vis"
                    #fname =  "%s_%02i_%02i_%02i.vis" %(ARGS.vis_prefix, vis.timestamp.hour, vis.timestamp.minute, vis.timestamp.second)
                    print 'saved ', vis, ' to', fname
                    visibility.Visibility_Save(vislist, fname)
                    vislist = []
            except Exception, e:
                logger.error( "PostProcessing Error %s" % str(e))
                logger.error(traceback.format_exc())
        else:
            time.sleep(0.00001)

import logging.config
import yaml
logger = logging.getLogger(__name__)

from pyqtgraph.Qt import QtGui, QtCore
import qt_view
import qt_graph

if __name__=="__main__":
    import argparse
    PARSER = argparse.ArgumentParser()
    PARSER.add_argument('--config', required=False, help="Config file.")
    PARSER.add_argument('--save_vis', required=False, action='store_true', help="generate abs and angle for vis")
    PARSER.add_argument('--vis_prefix', required=False, type=str, default='vis', help="generate abs and angle for vis")
    PARSER.add_argument('--blocksize', default=23, type=int, help='exponent of correlator block-size')
    PARSER.add_argument('--chunksize', default=10, type=int, help='number of vis objects per file')
    PARSER.add_argument('--mode', required=False, type=str, default='', help="syn, absang, calib")

    ARGS = PARSER.parse_args()
    

    if ARGS.mode!='':
        from monitor_vis import result_loop

    config = settings.Settings(ARGS.config)
    blocksize = ARGS.blocksize
    n_samples = 2**blocksize
    chunk_size = ARGS.chunksize

    path = 'logging.yaml'
    if os.path.exists(path):
        with open(path, 'rt') as f:
            log_config = yaml.load(f.read())
        logging.config.dictConfig(log_config)

    proc_queue = multiprocessing.Queue()
    result_queue = multiprocessing.Queue()
    
    vis_calc_process = multiprocessing.Process(target=process_loop, args=(proc_queue, result_queue, config, n_samples,))
    vis_calc_process.start()

    if ARGS.mode!='':
        if 'qt' in ARGS.mode:
            app = QtGui.QApplication([])
            if ARGS.mode == 'qt':
                 plotter = qt_view.QtPlotter(app)
            else:
                 plotter = qt_graph.QtPlotter(app)
            plotQ = plotter.getPort()
            post_process = multiprocessing.Process(target=result_loop, args=(result_queue, chunk_size, ARGS.mode, plotQ))
        else:
	    post_process = multiprocessing.Process(target=result_loop, args=(result_queue, chunk_size, ARGS.mode))
    else:
        # visibility save loop
	post_process = multiprocessing.Process(target=result_loop, args=(result_queue, chunk_size,))
    
    post_process.start()
    
    capture_process = multiprocessing.Process(target=capture_loop, args=(proc_queue,))
    capture_process.start()
    print 'started capture loop...'
 
    if ARGS.mode == 'qt':
        QtGui.QApplication.instance().exec_()
