tmolteno/TART/hardware/FPGA/tart_spi/bench/correlator/tart_correlator_tb.v

`timescale 1ns/100ps
/*
 * Module      : bench/correlator/tart_correlator_tb.v
 * Copyright   : (C) Tim Molteno     2016
 *             : (C) Max Scheel      2016
 *             : (C) Patrick Suggate 2016
 * License     : LGPL3
 * 
 * Maintainer  : Patrick Suggate <patrick.suggate@gmail.com>
 * Stability   : Experimental
 * Portability : simulation file, and only tested with Icarus Verilog
 * 
 * 
 * This file is part of TART.
 * 
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
 * 
 * Description:
 * Testbench for the TART correlator functional units.
 * 
 * NOTE:
 *  + OBSOLETE;
 * 
 * TODO:
 *  + update to use the latest versions of the correlator logic cores;
 * 
 */

`include "tartcfg.v"

module tart_correlator_tb;

   parameter BLOCK = `ACCUM_BITS;        // Number of bits of a block
   parameter MSB   = BLOCK-1;
   parameter ACCUM = BLOCK;     // Bit-width of the accumulators
   parameter ABITS = 12;        // Address bit-width
   parameter ASB   = ABITS-1;
   parameter BBITS = 8;
   parameter BSB   = BBITS-1;
   parameter MRATE = 12;
   parameter DELAY = 3;
   parameter COUNT = 3; // (1 << 3) - 1;
   parameter NREAD = 8;
   parameter BREAD = NREAD << 2;
   parameter XBITS = `BLOCK_BITS; // Bit-width of the block-counter
   parameter XSB   = XBITS-1;     // MSB of the block-counter
   parameter CBITS = 14;
   parameter CSB   = CBITS-1;

   wire [MSB:0] c_dat, c_val, blocksize, checksum;
   wire [CSB:0] c_adr;
   wire [BSB:0] dat, val, drx;
   reg          clk_x = 1, b_clk = 1, rst = 0, en = 0;
   reg          cyc = 0, stb = 0, we = 0, bst = 0;
   reg [2:0]    adr;
   reg [BSB:0]  dtx;
   reg          set = 0, get = 0, fin = 0;
   wire         ack;
   wire         c_cyc, c_stb, c_we, c_bst, c_ack;
   reg [23:0]   data [0:255];


   //-------------------------------------------------------------------------
   //  Setup correlator and bus clocks, respectively.
   always #5  clk_x <= ~clk_x;
   always #5  b_clk <= ~b_clk;
//    always #10 b_clk <= ~b_clk;


   //-------------------------------------------------------------------------
   //  Simulate two visibility calculations.
   integer      num = 0;
   integer      ptr = 0;
   initial begin : SIM_BLOCK
      $dumpfile ("../vcd/correlator_tb.vcd");
      $dumpvars;

      //----------------------------------------------------------------------
      $display("\n%8t: Generating fake antenna data:\n", $time);
      for (ptr = 0; ptr < 255; ptr = ptr+1)
        data[ptr] <= $random;

      //----------------------------------------------------------------------
      $display("\n%8t: Issuing reset:\n", $time);
      #33 rst <= 1; #40 rst <= 0;

      //----------------------------------------------------------------------
      $display("\n%8t: Setting up the block-size:", $time);
      #40 set <= 1; num <= 1; dtx <= COUNT; ptr <= 3'h5;
      while (!fin) #10;

      //----------------------------------------------------------------------
      $display("%8t: Beginning data-correlation (bank 0):", $time);
      #40  en <= 1; strobe <= 1;

      //----------------------------------------------------------------------
      $display("%8t: Switching banks (bank 1):", $time);
      while (!switching) #10;
      while (switching) #10;

      $display("\n%8t: Reading back a single visibility byte (bank 0):", $time);
      while (!newblock) #10;
      #10 get <= 1; num <= 1; ptr <= 3'h4;
      while (!fin) #10;

      $display("\n%8t: Reading back more visibilities (bank 0):", $time);
      while (fin) #10;
      #10 get <= 1; num <= BREAD-1; ptr <= 3'h4;
      while (!fin) #10;

      //----------------------------------------------------------------------
      while (!switching) #10; while (switching) #10;
      $display("\n%8t: Stopping data-correlation (bank 1):", $time);
      while (!wrap_cnt) #10;
      #10 en <= 0;

      //----------------------------------------------------------------------
      $display("\n%8t: Reading back visibilities (bank 1):", $time);
      while (!newblock) #10;
      #10 get <= 1; num <= BREAD; ptr <= 3'h4;
      while (!fin) #10;

      //----------------------------------------------------------------------
//       $display("\n%8t: Reading back counts (bank 1):", $time);
//       #80 get <= 1;
//       while (!fin) #10;

      //----------------------------------------------------------------------
      #80 $display("\n%8t: Simulation finished:", $time);
      $finish;
   end

   initial begin : SIM_FAILED
      #12000 $display ("TIMEOUT!");
      $finish;
   end // SIM_FAILED


   //-------------------------------------------------------------------------
   //  Read back visibility data, from the correlators' registers.
   //-------------------------------------------------------------------------
   wire       cyc_n = cyc && rxd == 1 && ack;
   integer    rxd = 0;

`ifndef __WB_CLASSIC
   always @(posedge b_clk)
     if (rst) bst <= #DELAY 0;
     else if ((set || get) && num > 2) bst <= #DELAY 1;
     else if (bst && num == 2 && !wat) bst <= #DELAY 0;
`endif

   always @(posedge b_clk)
     if (rst) begin
        {fin, get, set} <= #DELAY 0;
        {cyc, stb, we } <= #DELAY 0;
     end
     else if (set) begin
        $display("%8t: write beginning (num = %1d)", $time, num);
        {fin, get, set} <= #DELAY 0;
        {cyc, stb, we } <= #DELAY 7;
     end
     else if (get) begin
        $display("%8t: read beginning (num = %1d)", $time, num);
        {fin, get, set} <= #DELAY 0;
        {cyc, stb, we } <= #DELAY 6;
     end
     else if (cyc) begin
        if (!stb && ack) $display("%8t: transfer ending", $time);
`ifdef __WB_CLASSIC
        {fin, get, set} <= #DELAY { cyc_n, get, set};
        {cyc, stb, we } <= #DELAY {!cyc_n, !cyc_n, we && !cyc_n};
`else
        {fin, get, set} <= #DELAY { cyc_n, get, set};
        {cyc, stb, we } <= #DELAY {!cyc_n, bst || wat, we && !cyc_n};
`endif
     end
     else begin
        {fin, get, set} <= #DELAY 0;
        {cyc, stb, we } <= #DELAY 0;
     end

   always @(posedge b_clk)
     if (set || get) adr <= #DELAY ptr;

`ifdef __WB_CLASSIC
   always @(posedge b_clk)
     if (cyc && stb && ack) num <= #DELAY num - 1;
`else
   always @(posedge b_clk)
     if (cyc && stb && !wat) num <= #DELAY num - 1;
`endif // __WB_CLASSIC

   always @(posedge b_clk)
     if (get || set) rxd <= num;
     else if (cyc && ack) rxd <= #DELAY rxd - 1;

   //-------------------------------------------------------------------------
   // Display the data, and which correlator and register it is from.
   reg [10:0]   adr_r;
   reg [5:0]    ci;
   reg [4:0]    ri;
   reg [3:0]    rdys = 0, vals = 0;
   wire         rdy = cyc && !we && ack;

   assign dat = |{rdys, rdy} ? drx : 'bz;
   assign val = |{vals, set} ? dtx : 'bz;

   always @(posedge b_clk) begin
      rdys <= #DELAY {rdys[2:0], rdy};
      vals <= #DELAY {vals[2:0], set};
   end

   always @(posedge b_clk) begin
      adr_r    <= #DELAY rd_adr;
      {ci, ri} <= #DELAY adr_r;
      if (cyc && stb && !we && ack)
        $display("%8t: Vis = %08x (c: %02x, r:%02x)", $time, dat, ci, ri);
   end


   //-------------------------------------------------------------------------
   //  Generate fake DRAM contents.
   //-------------------------------------------------------------------------
   wire [23:0] data_w = data[data_index];
   integer     data_index = 0;
   reg         ready = 0;
   reg         aq_start = 0, aq_done = 1;
   wire        spi_busy, aq_request;
   wire [2:0]  aq_sample_delay;

   always @(posedge b_clk)
     if (rst)
       {aq_done, aq_start} <= #DELAY 2'b10;
     else if (!aq_start && aq_done && aq_enabled)
       {aq_done, aq_start} <= #DELAY 2'b01;
     else if (!aq_done && aq_start && aq_enabled)
       aq_start <= #DELAY 0;
     else
       aq_done  <= #DELAY aq_done ? aq_done : !aq_enabled;

   always @(posedge b_clk)
     if (rst)
       ready <= #DELAY 0;
     else if (aq_start || aq_request)
       ready <= #DELAY 1;
     else
       ready <= #DELAY 0;

   always @(posedge b_clk)
     if (rst)
       data_index <= #DELAY 0;
     else if (aq_request)
       data_index <= #DELAY data_index + 1;
     else
       data_index <= #DELAY data_index;

   //-------------------------------------------------------------------------
   //  Generate fake antenna data, from the fake DRAM contents.
   wire [23:0] antenna;
   reg [3:0]  cnt = 0;
   reg        strobe = 0;
   wire [3:0] next_cnt = wrap_cnt ? 0 : cnt + 1 ;
   wire       wrap_cnt = cnt == MRATE-1;
   integer    rd_adr = 0;

   assign antenna = data[rd_adr];

   always @(posedge clk_x)
     if (rst) cnt <= #DELAY 0;
     else     cnt <= #DELAY en ? next_cnt : cnt;

   always @(posedge clk_x)
     if (rst) rd_adr <= #DELAY 0;
     else     rd_adr <= #DELAY en && wrap_cnt ? rd_adr + 1 : rd_adr;

   always @(posedge clk_x)
     if (rst) strobe <= #DELAY 0;
     else     strobe <= #DELAY en && wrap_cnt;


   //-------------------------------------------------------------------------
   //     DATA-ACQUISITION CONTROL AND READ-BACK.
   //-------------------------------------------------------------------------
   wire [BSB:0] s_dat;
   wire [XSB:0] v_blk;
   wire         s_cyc, s_stb, s_we, s_ack;
   reg          wat = 0;
   wire         newblock, streamed, accessed, available, switching;
   wire         aq_debug_mode, aq_enabled;

   always @(posedge b_clk)
     wat <= #DELAY stb && bst && !ack;

   tart_acquire
     #( .WIDTH(BBITS), .ACCUM(ACCUM), .BBITS(XBITS)
        ) TART_ACQUIRE0
     ( .clk_i(b_clk),
       .rst_i(rst),
       .cyc_i(cyc),
       .stb_i(stb),
       .we_i (we),
       .ack_o(ack),
       .adr_i(adr),
       .dat_i(dtx),
       .dat_o(drx),

       .data_ready(ready),
       .data_request(aq_request),
       .data_in  (data_w),

       .spi_busy (spi_busy),

       .vx_cyc_o (s_cyc),
       .vx_stb_o (s_stb),
       .vx_we_o  (s_we ),
       .vx_ack_i (s_ack),
       .vx_blk_o (v_blk),
       .vx_dat_i (s_dat),
       
       .newblock (newblock),
       .streamed (streamed), // has an entire block finished streaming?
       .accessed (accessed),
       .available(available),
       .checksum (checksum),
       .blocksize(blocksize),

       .aq_debug_mode(aq_debug_mode),
       .aq_enabled(aq_enabled),
       .aq_sample_delay(aq_sample_delay)
       );

   //-------------------------------------------------------------------------
   //  VISIBILITIES STREAMING-READ-BACK LOGIC-CORE.
   //-------------------------------------------------------------------------
   wire [ASB:0] v_adr;
   wire [BSB:0] v_drx, v_dtx;
   wire         v_cyc, v_stb, v_we, v_bst, v_ack, v_wat;

   wb_stream
     #(  .WIDTH (BBITS),
         .WORDS (NREAD << 2),
         .WBITS (ABITS),
         .DELAY (DELAY)
         ) WB_STREAM0
       ( .clk_i(b_clk),
         .rst_i(rst),

         .m_cyc_o(v_cyc),       // this bus prefetches visibilities, and
         .m_stb_o(v_stb),       // sequentially
         .m_we_o (v_we),
         .m_bst_o(v_bst),
         .m_ack_i(v_ack),
         .m_wat_i(v_wat),
         .m_adr_o(v_adr),
         .m_dat_i(v_drx),
         .m_dat_o(v_dtx),

         .s_cyc_i(s_cyc),       // visibilities are streamed from here to the
         .s_stb_i(s_stb),       // SPI module
         .s_we_i (s_we),
         .s_bst_i(1'b0),
         .s_ack_o(s_ack),
         .s_dat_i('bx),
         .s_dat_o(s_dat),

         .wrapped(streamed)     // strobes when block has been streamed
         );

   //-------------------------------------------------------------------------
   //  VISIBILITIES READ-BACK UNIT.
   //-------------------------------------------------------------------------
   tart_visibilities
     #(  .BLOCK (BLOCK),
         .COUNT (NREAD),
         .TRATE (MRATE),
         .DELAY (DELAY)
         ) TART_VISIBILITIES0
       ( .clk_i(b_clk),
         .rst_i(rst),

         .cyc_i(v_cyc),
         .stb_i(v_stb),
         .bst_i(v_bst),
         .we_i (v_we),
         .ack_o(v_ack),
         .wat_o(v_wat),
         .adr_i({v_blk, v_adr}),
         .byt_i(v_dtx),
         .byt_o(v_drx),

         .cyc_o(c_cyc),
         .stb_o(c_stb),
         .we_o (c_we ),
         .bst_o(c_bst),
         .ack_i(c_ack),
         .wat_i(1'b0),          // TODO: Need something here?
         .adr_o(c_adr),
         .dat_i(c_dat),
         .dat_o(c_val),

         .switching(switching),
         .available(newblock),
         .checksum (checksum)
         );

   //-------------------------------------------------------------------------
   //     TOP-LEVEL CORRELATORS-BLOCK FUNCTIONAL UNIT.
   //-------------------------------------------------------------------------
   tart_correlator
     #(  .BLOCK (BLOCK),
         .DELAY (DELAY)
         ) TART_CORRELATOR0
       ( .clk_x(clk_x),
         .rst  (rst),
         .clk_i(b_clk),

         .cyc_i(c_cyc),
         .stb_i(c_stb),
         .we_i (c_we ),
         .bst_i(c_bst),
         .ack_o(c_ack),
         .adr_i(c_adr),
         .dat_i(c_val),
         .dat_o(c_dat),

         .enable(en),
         .blocksize(blocksize),
         .strobe(strobe),
         .antenna(antenna),
         .switch(switching)
         );


endmodule // tart_correlator_tb
