tmolteno/TART/(commit log)

2014-06-26 Increased width of 24V track
    [base_station_power_supply.brd]
2014-06-26 Changes to oscillator circuit. Added RJ45 for SPI
    [base_station.brd, base_station.sch]
2014-06-26 Added connector for 4 bits of data only
2014-07-02 Moved C1 down 1.5mm to increase clearance between capacitor and regulator
    [base_station_power_supply.brd]
2014-07-03 Added silk screen layers, and ammended component names to suit
    [base_station.brd, base_station.sch]
2014-07-03 Silk screen layer tidied up
    [base_station_power_supply.brd, base_station_power_supply.sch]
2014-07-03 Fixed board outline that was accidentally moved
    [base_station_power_supply.brd]
2014-08-22 first commit. tart(bram) with spi interface.
2014-08-23 Write alternating DEADBEEF and 0 to the SDRAM. Read from it once 1 second and turn on LED when read_out is DEADBEEF.
2014-08-23 first version of with sdram interface. python testbench indicates offset of 3. read_enable from the acquisition fifo is high for too long.
    [fifo_control.v, tart.v]
2014-08-23 introduced separate state for one read of from the aquisition buffer. seems to resolve the issue.
    [fifo_control.v]
2014-08-23 cranked numbers up to half a million samples. takes 22s to receive on the RPI. still minor bug to fix :)
    [fifo_control.v, tart.v]
2014-08-24 Bugfixes for state machine. now acquisition fifo gets read properly.
    [fifo_control.v]
2014-08-24 now 1 million samples! passes python testbench!
2014-08-24 Now supports transfers of more than 3 bytes of antenna data per transaction. retriving 1M 24bit samples takes 14s realtime.
2014-08-25 shift antenna data into separat arrays. prepare to put them into observation object.
2014-08-25 cranked up to 2+ million samples still some reserves.
2014-08-26 Setup debug mode. acquire 2mio samples. added reset and debugmode of fpga via register set by SPI.
2014-08-26 added reset, status and debug mode initiated via setting registers via spi.
    [fifo_control.v, spi_slave.v, tart.v]
2014-08-27 different way to generate antenna data array.. not really faster..
2014-08-28 Now working with modified SPI c library which returns numpy arrays instead of lists. fast!
2014-08-28 moved to SPI-NumPy for transfer.
2014-09-01 Added data sync module to project. added module to sync all antennas to receiving clock (16MHz from telescope into 320MHz domain).
2014-09-01 now properly acquiring 2**21 (24bit) samples. added 1 additional bit to compare >= treshold.
2014-09-02 Cleaned up version. Will transition into using device primitives in order to be licensing conform.
2014-09-02 moved to device primitive dcm instead of ipcore clk manager. still bugged. disabled data-clk sync for the moment.
    [tart.v]
2014-09-03 Added sync antennas based on fsm.
2014-09-03 Added updated version for antenna to clk sync.
2014-09-03 Added dummy block buffer module to see if xilinx infers dualported bram correctly. (yes it does).
    [fifo_control.v]
2014-09-09 fixed up logic for antenna input to register with the io register.
    [fifo_control.v, tart.v]
2014-09-12 added scad file for tile
    [tile.scad]
2014-09-12 moved tart spi operation into its own class.
2014-09-13 replaced vhd version with verilog version of the sdram controller.
    [SDRAM_Controller_v.v, tart.v]
2014-09-14 added fitting, transport config.
    [tile.scad]
2014-09-17 Getting libraries to work...
    [base_station_clock.sch, base_station_integrated.brd, base_station_integrated.sch, base_station_power_supply.sch, front_end_block.brd, transceiver_block.sch]
2014-09-18 Board layout progresses
    [base_station_integrated.brd]
2014-09-23 Work progresses on new base station board
    [base_station_clock.sch, base_station_integrated.brd, base_station_integrated.sch, base_station_power_supply.sch, transceiver_block.sch]
2014-09-24 Routine backup
    [base_station_clock.sch, base_station_integrated.brd, base_station_integrated.sch, base_station_power_supply.sch, transceiver_block.sch]
2014-09-25 Routine backup.
    [base_station_integrated.brd]
2014-10-01 updated colors and antenna positions for tile.
    [tile.scad]
2014-10-01 array of tiles
    [tile.scad]
2014-10-08 New libraries, and board updates
    [base_station_clock.sch, base_station_integrated.brd, base_station_integrated.sch, base_station_power_supply.sch, transceiver_block.sch]
2014-10-08 Vias added to make soldering of connectors easier on milled board.
    [base_station_integrated.brd]
2014-10-08 Fixed break in board outline
    [base_station_integrated.brd]
2014-10-09 Corrected hole sizes for vias and through hole ocmponents
    [base_station_integrated.brd]
2014-10-09 Corrected hole sizes for through hole components
2014-10-10 Sorted out issues with drill sizes
    [base_station_integrated.brd]
2014-10-10 box for the radio hub module.
    [radio_hub_box.scad]
2014-10-12 Added cover to TCXO. Connected pins on Raspberry Pi to ground
    [base_station_clock.sch, base_station_integrated.brd, base_station_integrated.sch, base_station_power_supply.sch, transceiver_block.sch]
2014-10-21 Changed footprints for voltage regulators, and board layout to suit
    [base_station_integrated.brd]
2014-10-23 Changed Papilio footprint so that all pins are installed. This helps to avoid errors when connecting. Swapped MISO and MOSI to maintain code compatibility with previous version.
    [base_station_clock.sch, base_station_integrated.brd, base_station_integrated.sch, base_station_power_supply.sch, transceiver_block.sch]
2014-10-29 backup - silkscreen generation and component renumber in progress
    [base_station_clock.sch, base_station_integrated.brd, base_station_integrated.sch, base_station_power_supply.sch, transceiver_block.sch]
2014-10-30 Updated silkscreen ready for manufacture
    [base_station_clock.sch, base_station_integrated.brd, base_station_integrated.sch, base_station_power_supply.sch, transceiver_block.sch]
2014-10-30 Added T & B to top and bottom copper layers
    [base_station_integrated.brd]
2014-10-31 Changed origin to bottom left corner of board for manufacture
    [base_station_integrated.brd]
2014-11-06 First commuit.
    [radio_hub.brd, radio_hub.sch, radio_hub_power_supply.sch]
2014-11-10 Schematic "done" - resolving ERC
    [radio_hub.sch, radio_hub_power_supply.sch]
2014-11-11 Component values added to schematic. Schematic now passes ERC
    [radio_hub.sch, radio_hub_power_supply.sch, radios.sch]
2014-11-12 Changed component names on board to match schematic
    [radio_hub.brd]
2014-11-12 Matching board to schematic. Fixing resistor orientations, vias
    [radio_hub.brd]
2014-11-13 Added a power switch
    [base_station_integrated.brd, radio_hub.sch, radio_hub_power_supply.sch]
2014-11-13 Replaced vias. updated zone clearances and design rules
    [radio_hub.brd]
2014-11-21 Address connectivity issues. Removal of connectors and rerouting of tracks
    [radio_hub.brd, radio_hub.sch, radio_hub_power_supply.sch, radios.sch]
2014-12-04 Base station and radio hub boards ready for final checks before manufacture
    [base_station_clock.sch, base_station_integrated.brd, base_station_integrated.sch, base_station_power_supply.sch, radio_hub.brd, radio_hub.sch, radio_hub_power_supply.sch, radios.sch]
2014-12-08 Made component references more logical - very similar to eagle version
    [base_station_clock.sch, base_station_integrated.brd, base_station_integrated.sch, base_station_power_supply.sch, transceiver_block.sch]
2015-07-30 simplified antenna now returns signal at baseband.
2015-07-31 Added support for setting delay of antenna data sampling clock from rpi via spi. new monitor.py for live display of antenna spectra and signal mean
2015-08-28 do not print
2015-09-14 Added basic antenna simulation structure
2015-09-16 New antenna
2015-10-01 exclude antennas currently not implemented
2015-10-08 Index antennas starting from 0.
2015-11-19 use db file for antenna. healpy map2alm no longer has kwarg regression
2016-03-18 base synthesis object on calibrated visibilities
2016-03-23 flagging all baselines with antenna (i)
2016-04-05 check vis object when loading from file. setter for config in calibration object
2016-04-28 added gain to calibration
2016-05-02 Added drawings for waveguide antenna
    [base.fcstd, cylinder.fcstd]
2016-05-04 Reduce memory footprint by storing data as float16
2016-05-05 base station with integrated power supply. host for raspberry pi B+ and Papilio Pro
    [base_station_integrated.kicad_pcb]
2016-05-05 tidyup. removed outdated schematics. added latest version pcb/schematics
    [base_station.brd, base_station.sch, base_station_clock.sch, base_station_integrated.brd, base_station_integrated.sch, base_station_power_supply.brd, base_station_power_supply.sch, clk_module.brd]
2016-05-11 Added printable endcap for Circular Waveguide Antenna
    [waveguide_endcap.scad]
2016-05-11 Added images for the radio hub and control board
2016-05-24 Rebuilt the TART SPI module to use asynchronous domains.
2016-05-24 Started working on improving the robustness of the data-capture circuits.
2016-05-24 SPI scripts modified to have one extra byte of delay.
2016-05-26 Added printed insert to hold antenna in place
    [waveguide_insert.scad]
2016-05-26 Reduced frame thickness
    [waveguide_insert.scad]
2016-05-31 SPI IOB timings have been modified for 100 MHz operation.
2016-06-01 Slight improvements to positions
    [waveguide_insert.scad]
2016-06-01 SPI tested, and passed, at 62.5 MHz. Code has been cleaned up a little.
2016-06-01 Signal capture code now considers all 24 phases, when aligning antenna data.
2016-06-03 Added C routines for SPI <-> TART communication.
2016-06-17 Still needs some more plumbing, index redirection, the SPI registers, and the 12x clock.
2016-06-18 Rejigging the SPI modules, as they are not currently very modular -- it is difficult to extend the architecture with more modules.
2016-06-20 Refactoring the toplevel TART and SPI modules, as they are hard to maintain, not modular, and performance is low (plus hard to quantify).
2016-06-21 Mostly finished refactoring the toplevel TART and SPI modules, now testing.
2016-06-24 Final version of SPI stuff seems to be working well. Next step it to connect the new aquisition and correlation hardware.
2016-07-12 Rebuilding the correlators to use the DSP48 primitives, as there are very few usable carry-chains within Spartan 6 FPGAs.
2016-08-10 Refactored the Python scripts to use spidev, but currently untested.
2016-09-05 Device meets timing with new antenna-pair layout.
2016-10-01 Still has the zero visibilities bug.
    [tart.v, tart_correlator.v, tart_dsp_tb.v, tart_fake_dsp.v, tart_visibilities.v, tartcfg.v, tartdsp.py, wb_prefetch.v]
2016-10-14 Found the SRAM bug. Now need to compute the permutation vector, for reordering the visibilities.
    [RAMB8X32_SDP.v, RAMB8X36_SDP.v, tart_dsp_tb.v, tart_fake_dsp.v, tartcfg.v, wb_chunk.v, wb_sram_interface.v]
2016-10-20 There is a visibilities read-back bug, and currently only the first correlator can be read.
    [fake_telescope.v, tart_bank_switch.v, tart_block_tb.v, tart_correlator.v, tart_correlator_tb.v, tartdsp.py]
2016-10-21 The visibilities read-back bug is inconsistent, and sometimes only the first correlator can be read.
    [LUT6.v, MUX8.v, MUXF7.v, RAMB16X32X8_TDP.v, RAMB16X32_TDP.v, RAMB8X32_SDP.v, correlate_cos_sin.v]
2016-11-02 Changed the visibilities permutation vector to reverse-permute ordering.
    [tart_capture.v]
2016-11-06 Added framework for multiprocessing with queue
2016-11-07 different process queue in case of monitoring
2016-11-07 Rewriting the data-acquisition module, as it was not robustly handling asynchronous signals. Currently unfinished though.
2016-11-10 removed threading. just multiprocessing
2016-11-24 Debugging the new data-capture, fixing clock-sync issues.
    [align_captures.v, capture.v, capture_control.v, fake_telescope.v, raw_acquire.v, signal_capture.v, signal_centre.v]
2016-11-30 Once the raw-data write addresses are fixed, the hardware is probably finished?
    [calibrate.py, raw_acquire.v, tart_capture.v, tart_testbench.py, tartdsp.py]
2016-12-05 Everything seems to be working, and there are no known bugs ATM. All that needs to be done is to improve the calibration script, as it needs to read and write phase-delay files.
    [IOBUF.v, ODDR2.v, calibrate.py, fifo_control.v, mcb_dummy.v, raw_acquire.v, tart.v, tart_acquire.v]
2016-12-06 Given Max the latest version for testing with six antennae. Improved various testbenches, to determine whether there is a \"first sample\" problem. All that needs to be done is to improve the calibra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
    [raw_acquire.v, signal_source.v, tart.v, tart_capture.v, tart_capture_tb.v, tartcfg.v]
2016-12-07 Fixed a fake-data generation bug, and improved the DSP-enable logic to prevent invalid data being correlated (when initialised in the wrong order).
    [IDDR2.v, SDRAM_Controller_v.v, fake_signal.v, fifo_control.v, raw_acquire.v, signal_phase_DDR.v, signal_stagger.v, tart.v]
2017-06-14 Fixed a bug that was causing pairs of means to have their ordering swapped.
    [correlate_cos_sin.v, tart_dsp_tb.v, tartcfg.v]
2017-06-16 Meets timing now, and had to redesign the DCM unit, so that XST could control the clock skews.
    [bank_switch.v, correlator_block.v, tart.v, tart_correlator.v, tart_dual_dcm.v, wb_reset.v]
2017-06-26 Fixed up the acquisition overflow, so now it only triggers when actually acquiring data.
    [fifo_control.v]
2017-06-28 define secret before attaching token auth
2017-06-28 created package for TART rpi2fpga communication. lowlevel driver as well as higher level functionality as well as a pythonic cli
2017-06-29 Updated layout of web app. Landing page will now display current mode. Logged in user will switch between modes when they click on a mode tab.
2017-06-30 removed threading. moved to multiprocesssing
2017-06-30 Fixed alignment of show/hide toggle buttons in diagnose mode view. Fixed alignment of FPGA status elements in diagnose mode view.
2017-06-30 polulate default dict in case spidev import fails
2017-07-05 more powers and roots
2017-07-06 fixed bug that was preventing apidoc from being accessable. Added synthesis parameters to display visibles (still need to implement refresh timer).
2017-07-06 Updated css, footer now sticks to bottom of window on mobile devices and looks much nicer. Imaging canvas now resizes when window size is changed.
2017-07-06 Loading bar now displays when browser is performing an API request. Fixed bug where web app was not redirecting to current mode view when logged in. Fixed bug where web app would continue to request 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
2017-07-07 Added info container to landing page.
2017-07-07 do not print newlines in list of registers
2017-07-09 require token for POST methods. added setter for exponent of number of samples acquired in raw mode
2017-07-12 fixed typo that was preventing SPI stats FIFO underrun from displaying.
2017-07-12 Added download image button to imaging component. Changed default refresh timer from 5 to 15 seconds.
2017-07-12 added API to set N_samples_exp for vis and raw, as well as save flags for each mode. more apidoc. replaced spaces with underscores.
    [tartspi.py]
2017-07-12 return 500 error when no antenna positions had been set
2017-07-12 serve antenna positions from telescope_config. therefore always available
2017-07-14 moved antenna positions out of telescope_config.json into own json files. made a clear distinction between design antenna positions and calibrated(corrected) antenna positions. This commit may break 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
    [highlevel_modes_api.py, stream_vis.py]
2017-07-14 Drawing antenna positions from static antenna position data in diagnose mode.
2017-07-18 Canvas now resizes when displayed on mobile devices.
2017-07-18 sqlite db for antenna gains
2017-07-18 added complex antenna gain parameters
2017-07-18 Created calibration service. Updated imaging comonent, it now takes calibration gain as an input. Started testing web-app.
2017-07-20 Added download gif button to imaging recorder component.
2017-07-24 Download gif and image buttons should now work in firefox.
2017-07-25 antenna based gain calibration from visibilities
2017-07-26 Added vis calibration component to vis mode.
2017-07-26 more API doc. save measured delay in database. no more diagnose mode at startup for setting sample delay. moved database routines in own file.
2017-07-26 store calibration process state in db.
2017-07-31 recovered schematic
    [base_station_clock.sch, base_station_integrated.sch, base_station_power_supply.sch, transceiver_block.sch]
2017-08-05 apply closed form of van vleck correction to relate quantized correlation coefficient to true analog corelation.
    [stream_vis.py]
2017-08-09 save json from calibration post request
2017-08-10 removed print
2017-08-14 Update README with antenna image
2017-08-15 calibration bug
2017-08-17 3pole antenna position calibration values
2017-08-19 Basic lab based calibration for radio hubs. First draft
2017-08-20 Added sample request
2017-08-20 Added sample url to apidoc
2017-08-23 Tool to monitor specific baseline for calibration purposeses.
2017-08-24 Added calibration offsets
2017-08-25 load antenna positions into settings object.
2017-08-30 revisited projection for source catalog overlay. adjusted range for imaging parameters and refresh timer.
2017-08-31 Added Tim Miller
2017-08-31 Updated Tim Millers email address
2017-08-31 Update install framework
2017-09-20 Modify antenna rotation to allow it to be done for all antennas at once
2017-09-26 Added first draft of api for setting antenna positions
2017-09-27 Added basic POST method for antenna positions
2017-09-27 Some logging in antenna positions
2017-09-27 array render
    [tile.scad]
2017-10-26 Added command line option to use a calibration data file to image
2017-11-28 Zynq can read antenna data and dump to kernel log.
2017-11-28 Capture antenna values on rx_clk_16.
2017-11-30 Most of the tart_spi has been integrated into tart_1.0 IP.
    The SPI bus has been replaced with an AXI bus which is not
    yet fully implimented. Currently it works as a delayed response
    to 4 registers. Next it will need to talk over the wishbone
    bus to read and write register values.
    SRAM or some kind of replacement has not yet been implimented.
    Clocks are genereted by Xilinx Clock Wizard with connects to the
    tart IP as I couldn't figure out how to put that in the tart IP.
    [constraints.xdc, design_1_wrapper.v, fifo_control.v, main.c, tart.h, tart_v1_0.v, tart_v1_0_S00_AXI.v, tartcfg.v]
2017-12-07 Clocking wizard is working on con2.
    I am not sure why con1 doesn't seem to be working.
    [constraints.xdc, design_1_wrapper.v, main.c, tart_v1_0.v, tart_v1_0_S00_AXI.v]
2017-12-11 Starting to join AXI and wishbone. Not working.
    Addresses are not being transfered properly and reading
    always returns 0.
    [main.c, tart.v, tart_v1_0.v, tart_v1_0_S00_AXI.v, tart_wishbone.v]
2017-12-11 Kernel module reads registers from most devices.
    However the only thing that returns non zero is
    wb register 0x2, the capture unit address b10. which
    returns the number of antenna.
2018-01-24 DMA from acquire is working with a counter.
2018-01-24 AXI DMA implimented.
    There seems to be a bug with enabling the correlator that causes
    pl to hang.
    DMA times out the first time the module is loaded. I am not sure
    why as pl gets reset by the module.
    The files zynq uses that are different from tart_spi will be moved
    to the zynq directory and this branch will be merged into master
    soon.
    PL side of zynq support is almost done.
    [main.c, tart_acquire.v, tart_v1_0.v]
2018-01-25 The test kernel driver seems to be working.
2018-01-30 Added calibration script
2018-03-16 added simple script for extraction of raw data samples from single antenna
2018-08-30 Added a volume to mount
2018-09-03 Added a basic Dockerfile to run the calibration process
2018-09-04 Make this container calibrate once
2018-09-06 Update docker files to work better on raspberry pi
2018-09-06 Add device information to the docker compose file
2018-09-16 Added a little more context to the descri the description of the calibration
2018-09-20 Docker is now working on the raspberry Pi!
2018-09-28 Updated calibration docs.
2018-09-28 Add a couple of containers for debug app builds - they reload when code is changed
2018-09-28 Added a dummy SPI module that will hopefully allow debugging on a host without a radio
2019-02-07 Added a restart option to the api_doc_server container. Uncomment the SPI device
2019-02-14 Added note about antenna positions
2019-02-14 Add converted kicad projects
    [RadioHub2.1.kicad_pcb, RadioHub2.1.sch, RadioHub2.1_1.sch, RadioHub2.1_2.sch, RadioHub2.1_3.sch, RadioHub2.1_4.sch, base_station_clock.sch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]
2019-02-14 Move to new timer from rxjs
2019-02-14 Modify to upload antenna positions (take into account the rotation reported by the calibration)
2019-02-21 bom update
    [RadioHub2.1_1.sch, RadioHub2.1_2.sch, RadioHub2.1_3.sch, RadioHub2.1_4.sch, base_station_clock.sch, base_station_integrated.kicad_pcb, base_station_integrated.sch, base_station_power_supply.sch]
2019-02-21 Move to python3 print style
2019-02-21 Added BOM stuff
    [RadioHub2.1.pdf_bom_.csv, RadioHub2.1_.csv, RadioHub2.1_bom_.csv, base_station_clock-2019-02-21-13-44-59.sch, base_station_integrated-2019-02-21-13-44-59.sch, base_station_integrated_.csv, base_station_power_supply-2019-02-21-13-44-59.sch, front_end_block.sch]
2019-02-22 Change config attribute for num antennas
2019-02-26 Updated the varous python modules to python3. Many fixes
    [calibrate.py, stream_vis.py]
2019-02-26 Import time, and catch exception correctly
    [stream_vis.py]
2019-02-26 Moved things around so that old files are in the legacy directory
    [RadioHub2.1.kicad_pcb, RadioHub2.1.sch, RadioHub2.1_1.sch, RadioHub2.1_2.sch, RadioHub2.1_3.sch, RadioHub2.1_4.sch, base_station_clock.sch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]
2019-02-26 Update dummy spi. Still not returning useful test data
2019-02-28 Move calibration to python3
2019-03-04 Moved bom files
    [RadioHub2.1.pdf_bom_.csv, RadioHub2.1_.csv, RadioHub2.1_bom_.csv]
2019-03-08 New tests and database rework for antenna models
2019-03-11 Updated to store HDF5 files. Part of resolving Issue #40
    [highlevel_modes_api.py, stream_vis.py, tart_testbench.py, tartspi.py]
2019-03-12 Updated observation load to choose HDF files if the extension is right. Refers to Issue #40
    [highlevel_modes_api.py]
2019-03-13 Update testbench to add visibility exporters for HDF format, and to rename Visibility_Load/Save to list_load and list_save, since they do not actually save individual visibility objects. Related to I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
    [highlevel_modes_api.py]
2019-05-06 Remove bug in print
2019-05-14 Update to include basic point source calibration
2019-05-15 Update antenna model code to allow loading from data.
2019-08-29 Added basic LNA board
    [lna.kicad_pcb, lna.sch]
2020-08-26 Save antenna positions with VIS files
2021-03-10 Better printing in API service
2022-05-06 Hardware files added
    Hardware files added
    [base_station_clock.sch, base_station_integrated.brd, base_station_integrated.sch, base_station_power_supply.sch, radio_hub.brd, radio_hub.sch, radio_hub_power_supply.sch, radios.sch]
