tmolteno/TART/(notices)

Notices in the files:
hardware/FPGA/tart_spi/verilog/capture/capture.v:
TART is free software: you can redistribute it and/or modify it under the
terms of the GNU Lesser Public License as published by the Free Software
hardware/FPGA/tart_spi/verilog/SDRAM_Controller_v.v:
the Free Software Foundation, either version 3 of the License, or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
hardware/FPGA/zynq/kernel/main.c:
it under the terms of the GNU General Public License version 2
